ikouchiha47/cybertron/docs/design_iterations/case_v3.html

WristTurn — Case v3

drag · scroll · right-drag pan

Case v3 — back-to-back stack

Inner cavity: 26 × 30 × 11.5 mm

Wall: 1.5 mm

Outer body: 29 × 33 × 14.5 mm

Strap slot: 22 × 3 mm (each side)

USB-C cutout: 9 × 4 mm (+Z face)

vs case v2 (35×30×16mm)

Width: 35→29 mm −6mm ✓

Height: 16→14.5 mm −1.5mm ✓

Depth: 30→33 mm +3mm (battery)

Stack layers

LiPo 502030: 30×20×5 mm 200mAh

BNO085 Qwiic: 25.4×17.8×2.5 mm

Qwiic gap: 0.5 mm

XIAO nRF52840: 21×17.5×3.5 mm

Inner stack: 11.5 mm

Stack Shell Explode Cross-section Wrist Rendered
