ikouchiha47/cybertron/writstturn_adapter/shots/caps/Screenshot 2026-04-04 at 3.59.33 PM.png

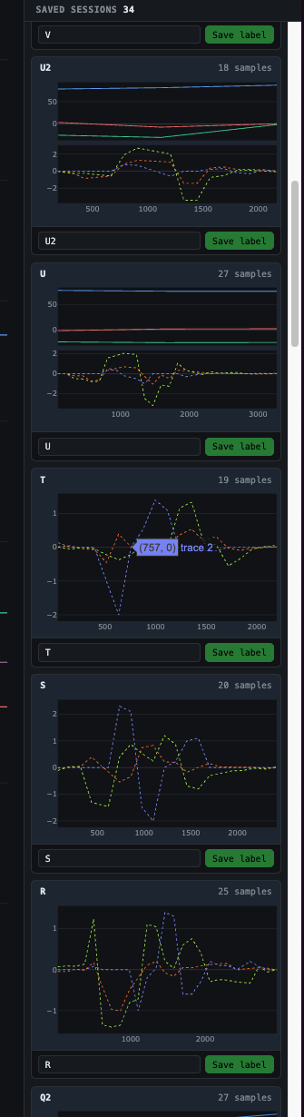
writstturn_adapter/shots/caps/Screenshot 2026-04-04 at 3.59.33 PM.png
