ikouchiha47/cybertron/writstturn_adapter/shots/caps/Screenshot 2026-04-04 at 4.00.03 PM.png

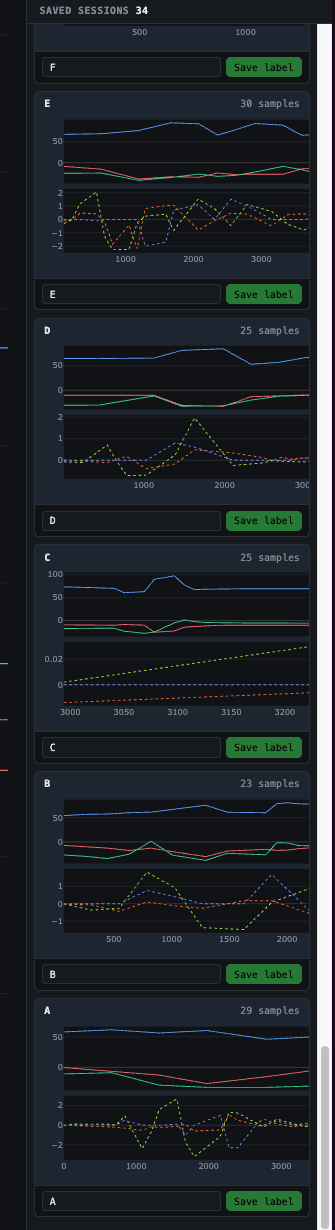
writstturn_adapter/shots/caps/Screenshot 2026-04-04 at 4.00.03 PM.png
