ikouchiha47/cybertron/writstturn_adapter/shots/small/Screenshot 2026-04-04 at 3.44.17 PM.png

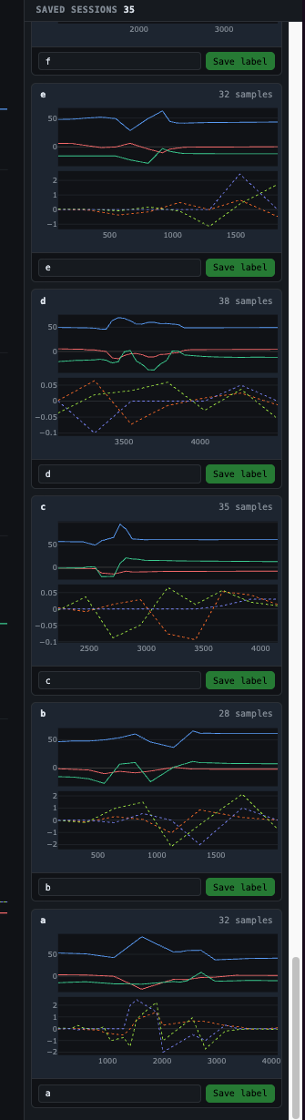
writstturn_adapter/shots/small/Screenshot 2026-04-04 at 3.44.17 PM.png
