ikouchiha47/cybertron/docs/PARTS.md

Parts Used:

- bn0085 qwiic fusion breakout board
- seed studio nRF52840 sense module
- breadboard

Extra:

- TP0456 battery charger
- 3.7V 200mAH battery

Software:

- audrio studio
    Version: 2.3.8
    Date: 2026-02-25T15:19:41.995Z
    CLI Version: 1.4.1

Audrino IDE;

- https://wiki.seeedstudio.com/XIAO_BLE/

Arduino Libraries:

- SparkFun BNO08x Arduino Library  (used by wristturn_bno085.ino.bkp)
- Seeed Arduino LSM6DS3             (used by wristturn.ino — onboard IMU)

  ├─────────────────────────────────────────────┼─────────────────┤
  │ Raytac MDBT50Q module (nRF52840, certified) │ ₹450–600        │
  ├─────────────────────────────────────────────┼─────────────────┤
  │ BNO085 bare chip                            │ ₹350–450        │
  ├─────────────────────────────────────────────┼─────────────────┤
  │ LDO + charger + passives + PCB              │ ₹300–400        │
  ├─────────────────────────────────────────────┼─────────────────┤
  │ Assembly                                    │ ₹300–500        │
  ├─────────────────────────────────────────────┼─────────────────┤
  │ Total                                       │ ₹1400–1950/unit │
