ikouchiha47/cybertron/(commit log)

2026-03-30 feat: initial commit for roll, pitch, yaw
2026-03-30 feat: adds yaw and pitch and tap log
2026-03-31 refactor: addind deadzones and stability metrics to track hand movements naurally
    note: One thing to note: stability is still firing every ~40ms, not 500ms as intended. The rebase being blocked isn't causing problems right now, but worth knowing the interval isn't exactly 500ms. Not a bug at this stage though.
    [log.h, wristturn.ino]
2026-04-07 feat: tap detection, force-rebase fix, case design iterations
    - Add setupTapDetection() with correct TAP_CFG=0x8F (INTERRUPTS_ENABLE|LIR)
    on LSM6DS3TR-C; polling TAP_SRC bit5 with 500ms software debounce
    - Add force-rebase safety net guarded by accelStill to rescue locked-out
    axes without causing phantom gestures mid-movement
    - Add case_v1.html and case_v2.html 3D design iterations (Three.js)
    - Update PARTS.md with custom PCB BOM estimate (₹1400-1950/unit)
    [wristturn.ino]
2026-04-07 feat: swap active firmware to BNO085, archive LSM6DS3 as nrf52840 bkp
    [wristturn.ino]
2026-04-07 docs+opt: power optimizations and 6DOF yaw failure analysis in DESIGN.md
    [wristturn.ino]
2026-04-07 feat: case_v3 three.js — BNO085+XIAO back-to-back, 29×33×14.5mm
2026-04-27 fix(firmware): resolve BNO08x enable failures by reverting imu.begin() to 2-arg form and adding explicit attachInterrupt()
    - SparkFun BNO08x Cortex library has race condition: passing INT pin to begin()
    causes hal_wait_for_int() to run before every enableReport(), deadlocking
    - Use imu.begin(address, Wire) without INT pin to bypass broken path
    - Add attachInterrupt(BNO085_INT_PIN, [], FALLING) so waitForEvent() wakes
    - Document this library bug in CLAUDE.md for future maintainers
    - Also includes calibration state fixes (calibrationComplete, baselineCaptured globals,
    staged enableReports on arm, baseline write callback) from earlier refactor
    [wristturn.ino]
2026-04-28 feeat: fixing gesture issues and wake up fix
    [event_queue.h, shake_detector.h, state_packet.h, wristturn.ino]
2026-05-01 feat: implementing soft and deeper sleep power managemengt and adaptive reporting to savve battery
2026-05-01 fix: return from sleep loop early to prevent DEADLOCK warnings and waitForEvent with INT LOW
    - add return after delay(10) in sleeping block so loop() skips dispatch,
    keepalive, DEADLOCK check, and waitForEvent during sleep cycles
    - fix code_memory hook: use continue=true + systemMessage instead of
    continue=false + stopReason which was halting Claude after blocked reads
    [wristturn.ino]
2026-05-01 feat: stage logging, 10min light sleep, validated power management docs
    - log sleep stage transitions (stage=0 light / stage=1 deep) with lastStage=0xFF fix
    - increase light sleep duration from 4.5 min to 10 min before deep sleep
    - document DEADLOCK bug root cause and fix in POWER_MANAGEMENT.md
    - document confirmed SigMotion wake from hardware logs (logs.39, session log)
    [wristturn.ino]
2026-05-01 docs: document historical sleep wake failures from logs.34-37
    Four failed approaches to shake-to-wake are now recorded:
    - INT-pin based wake with wakeupEnabled=true (device stuck draining for 9h)
    - 10s guard window to absorb SHTP ACKs (still woke on next periodic report at 10006ms)
    - Reduced shake interval + guard window (woke every ~12s on periodic reports)
    - Discovery that SH2_SHAKE_DETECTOR fires at its interval unconditionally
    Also documents that SigMotion requires 5-step walking pattern (not arbitrary motion),
    and updates the "not yet validated" note to confirmed based on logs.39.
    Log snippets are pulled directly from tmp/logs.34-37 and tmp/logs.39.
2026-05-02 refactor: power ,management
2026-05-07 feat: unify gesture system — remove knob mode, add HoldDetector
    Replaces the gesture/knob/symbol three-mode split with one motion-shape
    recognizer per docs/UNIFIED_GESTURE_DESIGN.md. Two detectors (existing
    velocity-domain AxisDetector in firmware + new position-domain HoldDetector
    in app) feed the same engine and the same gesture-name vocabulary.
    Why: the prior split had layered policy (tap meaning different things on
    different screens), a knob_tick± vocabulary that doubled the mapping table,
    and an accidental fatigue filter where slow deliberate motion was rejected.
    Unifying gives users one mapping per intent and adds auto-repeat + cruise-lock
    as a natural extension of any axis flick.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
    [state_packet.h, wristturn.ino]
2026-05-08 docs(firmware): add C++ concurrency & safety conventions
    Document cross-task state handling (volatile vs atomicity), Power-of-10
    rules as applied to this codebase, and the planned Atomic<T> wrapper as
    future work. Triggered by audit of heartbeat block — single-task locals
    safe, but cross-task globals need a documented rule.
2026-05-08 build(firmware): add Makefile, refresh firmware.uf2 snapshot
    make build produces firmware.uf2 + wristturn/firmware.hex from the
    current sketch via arduino-cli + uf2conv. make flash drag-drops to the
    XIAO bootloader volume. Replaces the prior manual Arduino-IDE workflow
    so the committed firmware.uf2 stays in sync with the source.
2026-05-08 feat: tune arbitrator floor + screen wake locks + AC robustness
    Firmware:
    - Bumped GestureArbitrator MIN_INTEGRAL from 0.20 to 0.30 rad to cut the
    0.15-0.30 rad bleed band seen in arm-up/arm-down arc-motion logs while
    keeping legitimate gentle gestures (0.30+ rad) intact. Symbol mode
    unaffected (raw IMU path, not arbitrator).
    App — Discovery:
    - Settle gate on pitch_down -> openDevice bumped 500 -> 800 ms to match
    arm_up/arm_down gobbleMs and catch the 731 ms inter-fire bleed gap
    observed in real-use logs.
    App — ActiveControl robustness:
    - Connect timeout: 5 s race against proxy.connect(); if device proxy
    doesn't respond (e.g. TV powered off), navigate back to Discovery
    wi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
2026-05-11 feat: per-axis arbitrator config + WAL logs + sleep timing + power-mgmt fixes
    Firmware
    ========
    Sleep / wake (fixes false-wake regression and tunes battery target ~24h):
    - PowerManager.h ShakeSleepPolicy now uses always-on domain + INT-driven
    wake (wakeupEnabled=true, INT-LOW poll) instead of the 30s wake-the-hub
    + drain polling. Commit a1ce55a had broken this by setting
    SHAKE_POLL_INTERVAL_US=10ms, which made the BNO emit periodic fake shake
    reports during every drain window and triggered constant false wakes.
    Set SHAKE_POLL_INTERVAL_US=0 (proper event-sensor arming per SH-2).
    - Reverted drainFifo early-exit threshold 150ms -> 20ms (paired with the
    10ms regression).
    - WristTurn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
    [PowerManager.h, log.h, wristturn.ino]
2026-05-11 chore(android): track native BLE service via overlay-and-sync pattern
    The wristturn-app/android/ directory is gitignored because Expo regenerates
    it on every `npx expo prebuild`. This was hiding the BLE foreground service
    implementation (700 lines in BLEForegroundService.kt plus module/package
    glue plus manifest entries) from version control, so cloning the repo and
    prebuilding wouldn't reproduce a working APK.
    Approach: keep the source of truth in a tracked native-overlay/ tree and
    sync into android/ on demand.
    wristturn-app/native-overlay/ ← tracked
    android/app/src/main/
    AndroidManifest.xml
    java/com/anonymous/wristturnapp/
    BLEForegroundService.kt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
